iwasz/zephyr-grbl/doc/TMC2130-Pinout-with-Legend-1.jpg

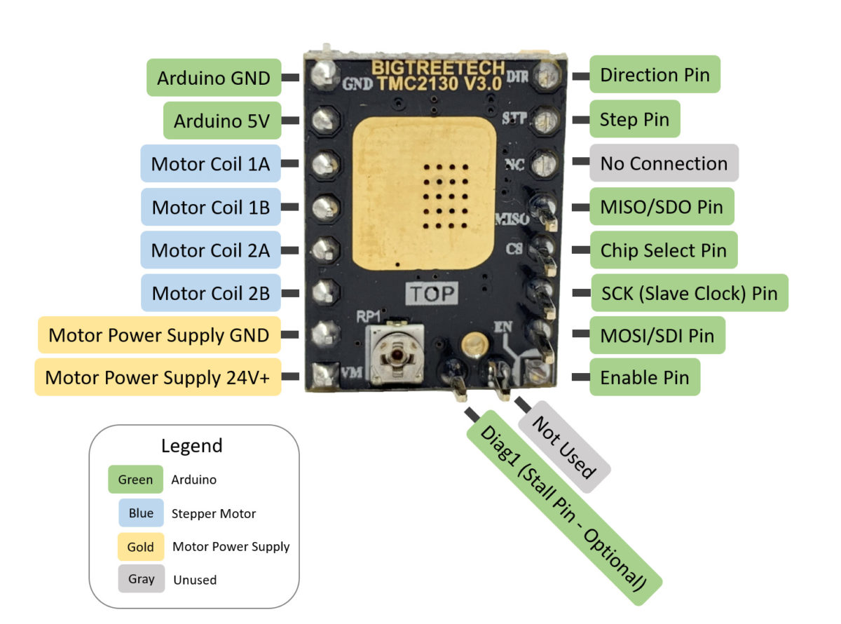
doc/TMC2130-Pinout-with-Legend-1.jpg
