iwasz/zephyr-grbl/pcb/plotter/plotter.jpg

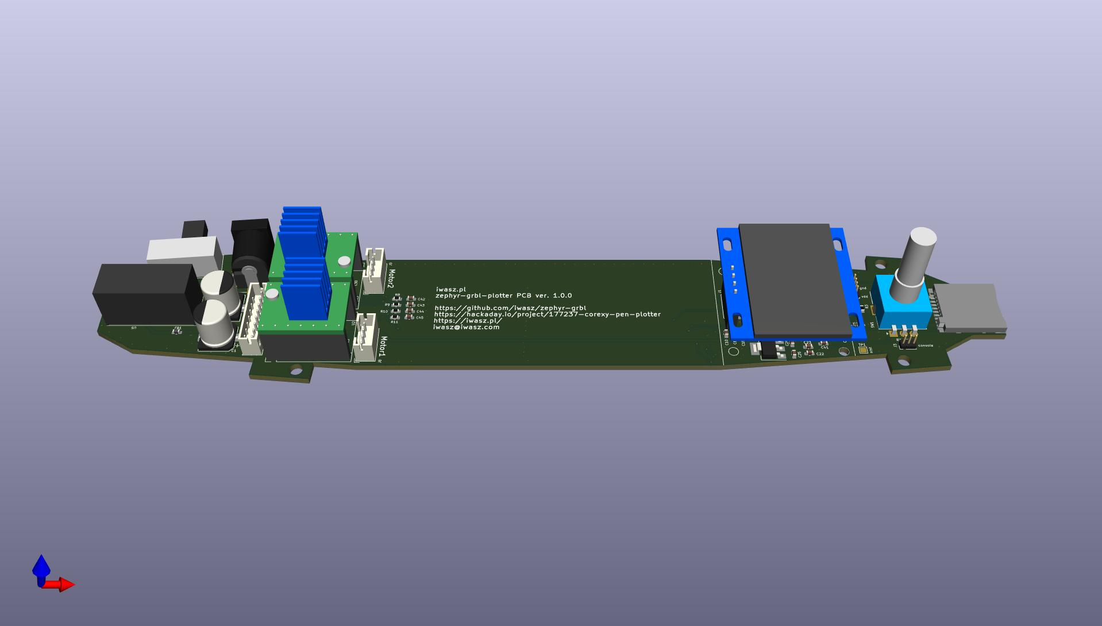
pcb/plotter/plotter.jpg
