iwasz/zephyr-grbl/freecad/plotter-dag-ModelEast attachment body.stl

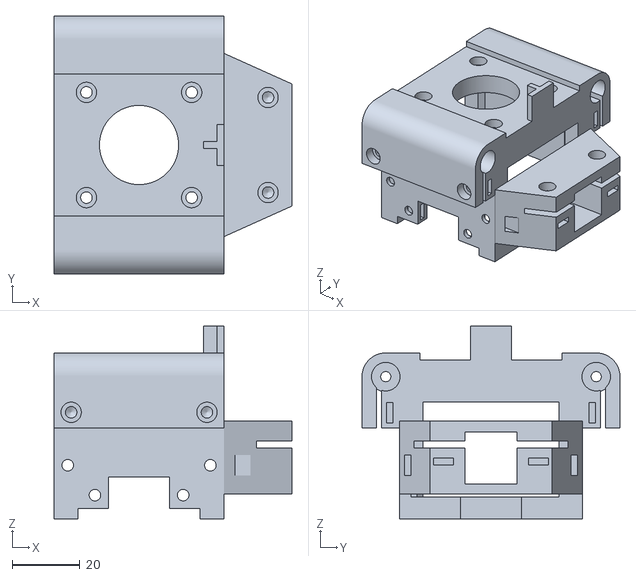
[picture p3: CAD file, 2021-11-13]
freecad/plotter-dag-ModelEast attachment body.stl
70.0 x 76.0 x 56.8
