iwasz/zephyr-grbl/freecad/misc.FCStd

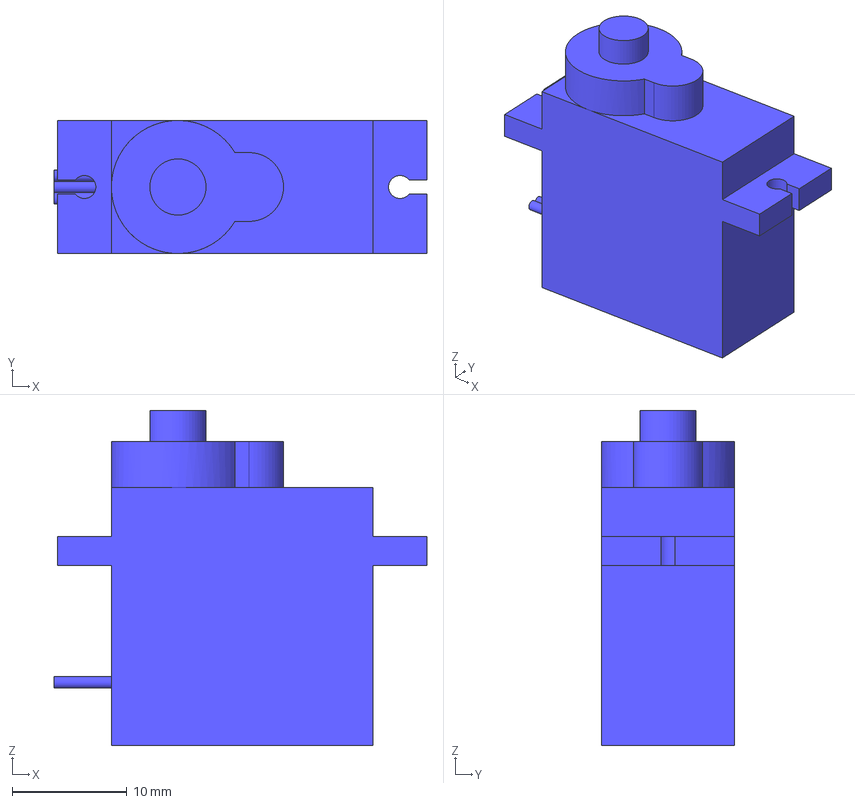
[picture p4: CAD file, 2021-11-13]
freecad/misc.FCStd
32.5 x 11.6 x 29.2 mm
