iwasz/zephyr-grbl/freecad/west-supports.3mf

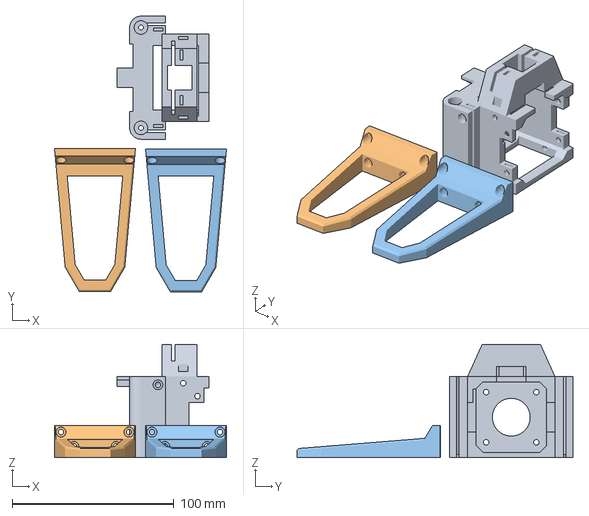
[picture p5: CAD file, 2021-11-13]
freecad/west-supports.3mf
106.2 x 170.2 x 70.0 mm
plotter-dag-ModelEast attachment body.stl
plotter-dag-ModelStand.stl x 2
