iwasz/zephyr-grbl/freecad/east-supports.3mf

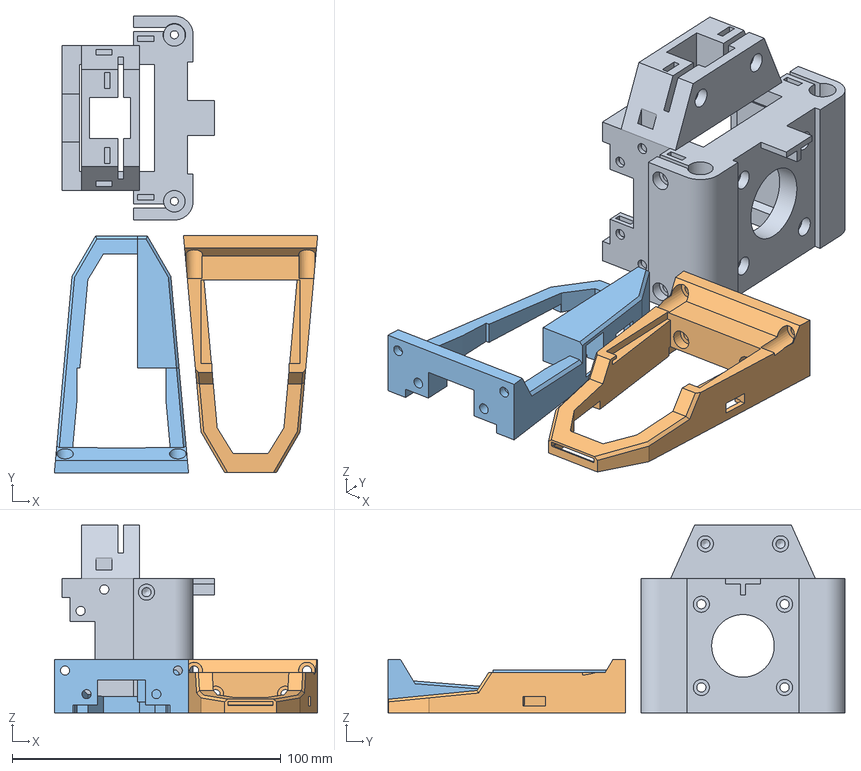
[picture p6: CAD file, 2021-11-13]
freecad/east-supports.3mf
98.1 x 170.2 x 70.0 mm
plotter-dag-ModelLink045(East attachment body).stl
plotter-dag-ModelStand001 (display).stl
plotter-dag-ModelStand002 (drivers).stl
