iwasz/zephyr-grbl/freecad/structure.FCStd

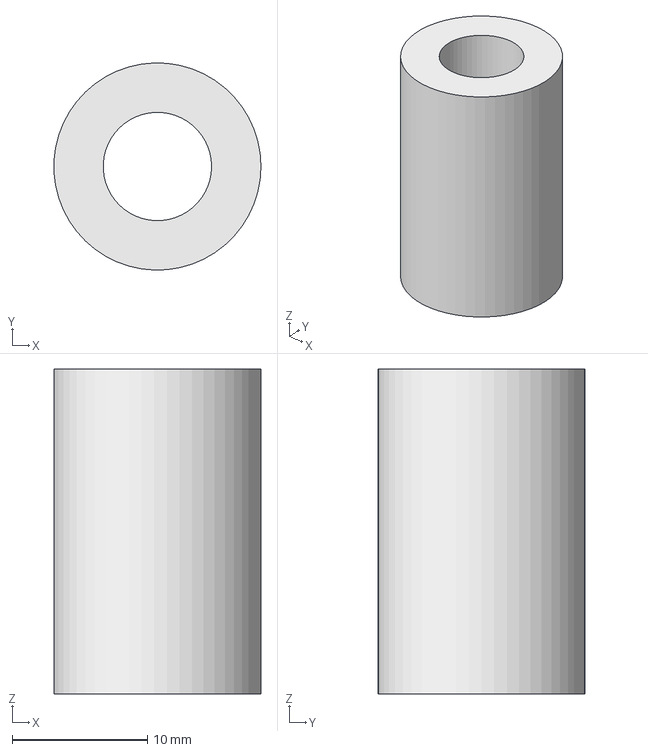
[picture p7: CAD file, 2021-11-13]
freecad/structure.FCStd
15.3 x 15.3 x 24.0 mm
