iwasz/zephyr-grbl/freecad/pcb.FCStd

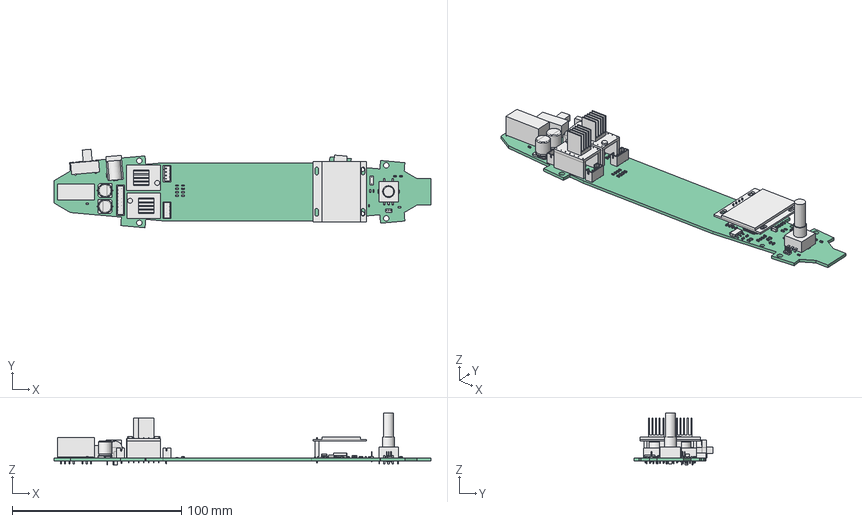
[picture p8: CAD file, 2021-11-13]
freecad/pcb.FCStd
222.6 x 46.4 x 30.5 mm
Pcb_8af9
C32_C_0603_1608Metric_dea1ef8ef69a x 38
C29_CP_Elec_8x10_c7fa17566931 x 4
R3_R_0603_1608Metric_c1fe3c621b06 x 13
J3_PinHeader_1x03_P127mm_Vertical_99a3a563f8fd
FB1_L_0603_1608Metric_5fb4f000be9f
SW2_Part_cp_a7f6e6a6a0c3
SW1_Part_cp001_6f12c7833242
U3_Part_cp_1e66df32675e x 2
U6_SOT_223_f1b97c54386c
U5_Part_cp_951aa2137d22
J2_PinHeader_1x04_P127mm_Vertical_8b0e2712847d
J5_Part_cp_6f4ee88f3ece
J1_Part_cp_9450c610c26b
J9_JST_B4B_PH_K_399ff7b9d37a x 2
C21_C_1206_3216Metric_187a28c8282d x 2
J6_Part_cp001_eeae0143ed6b
U1_LQFP_64_10x10mm_P05mm_76695abe2553
J10_JST_B8B_PH_K_8ebf37ab7c3a
C16_C_1210_3225Metric_90d36acb180e
