iwasz/zephyr-grbl/freecad/17HS4401.FCStd

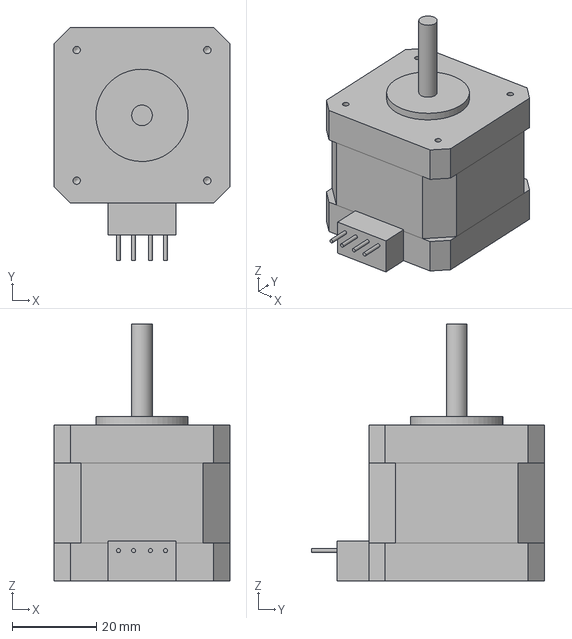
[picture p9: CAD file, 2021-11-13]
freecad/17HS4401.FCStd
41.7 x 55.3 x 61.0 mm
