iwasz/zephyr-grbl/freecad/plotter-dag-ModelStand002 (drivers).stl

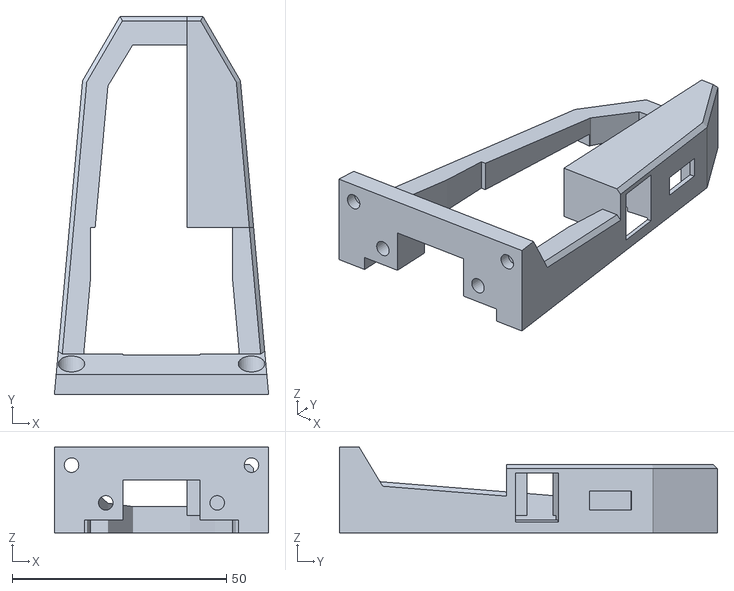
[picture p10: CAD file, 2021-11-13]
freecad/plotter-dag-ModelStand002 (drivers).stl
50.0 x 88.2 x 20.0
