iwasz/zephyr-grbl/freecad/plotter-dag-ModelSlice1.stl

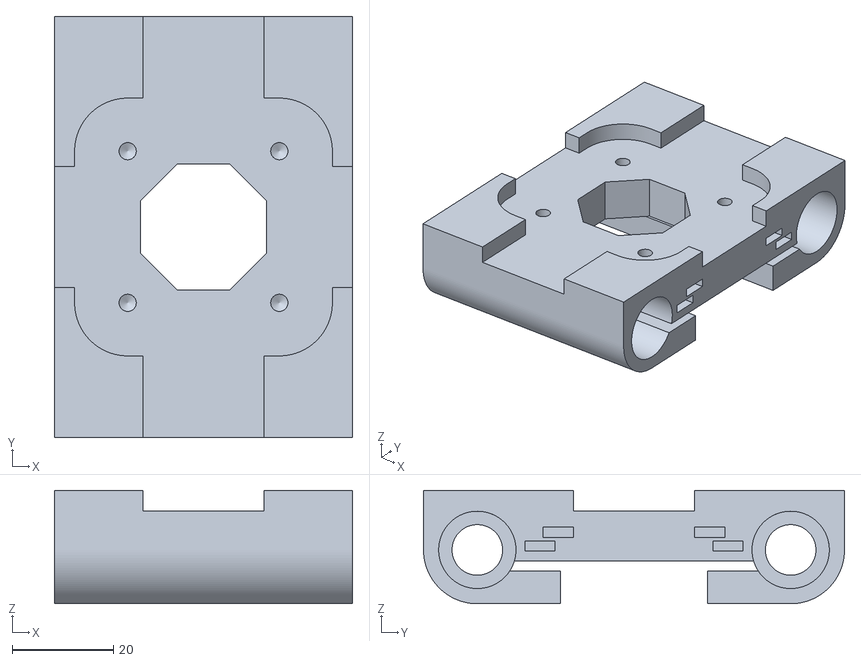
[picture p11: CAD file, 2021-11-13]
freecad/plotter-dag-ModelSlice1.stl
59.0 x 83.3 x 22.5
