iwasz/zephyr-grbl/freecad/gt2.FCStd

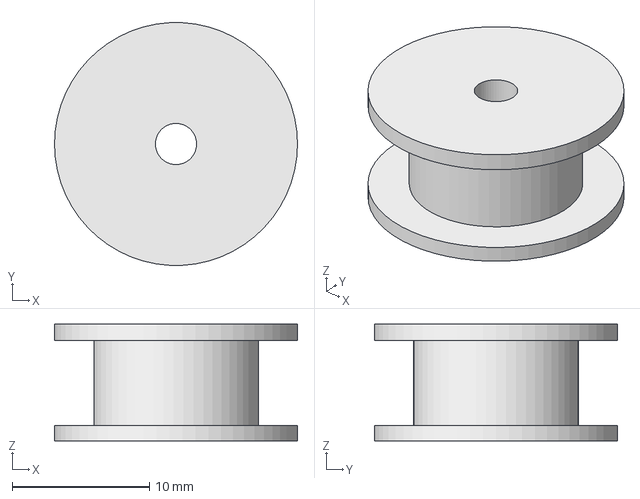
[picture p12: CAD file, 2021-11-13]
freecad/gt2.FCStd
17.7 x 17.7 x 8.50 mm
