iwasz/zephyr-grbl/freecad/carrier.3mf

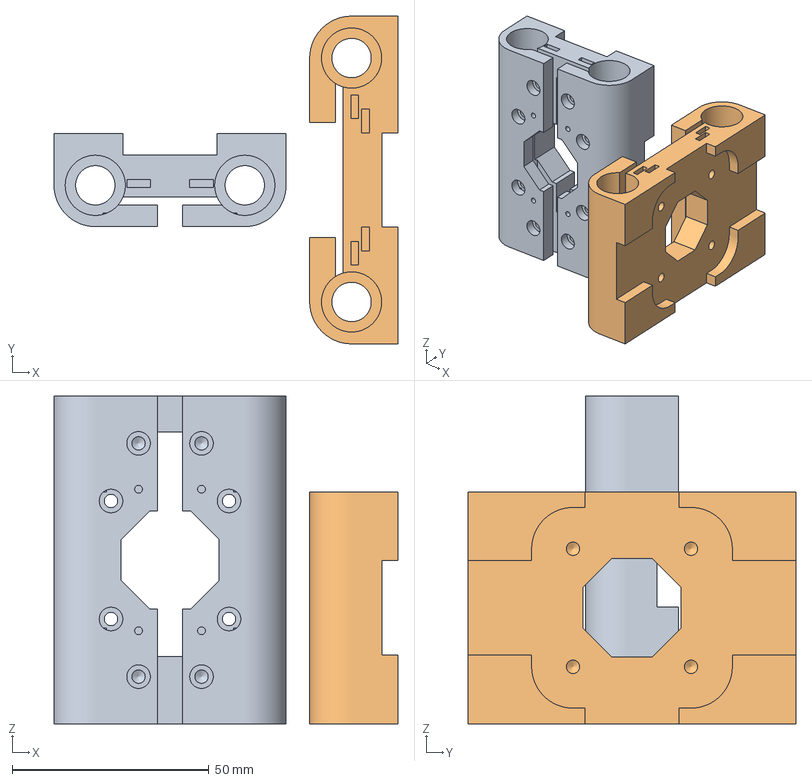
[picture p13: CAD file, 2021-11-13]
freecad/carrier.3mf
87.5 x 83.3 x 83.3 mm
plotter-dag-ModelSlice0.stl
plotter-dag-ModelSlice1.stl
