iwasz/zephyr-grbl/freecad/plotter-dag-ModelSlice0.stl

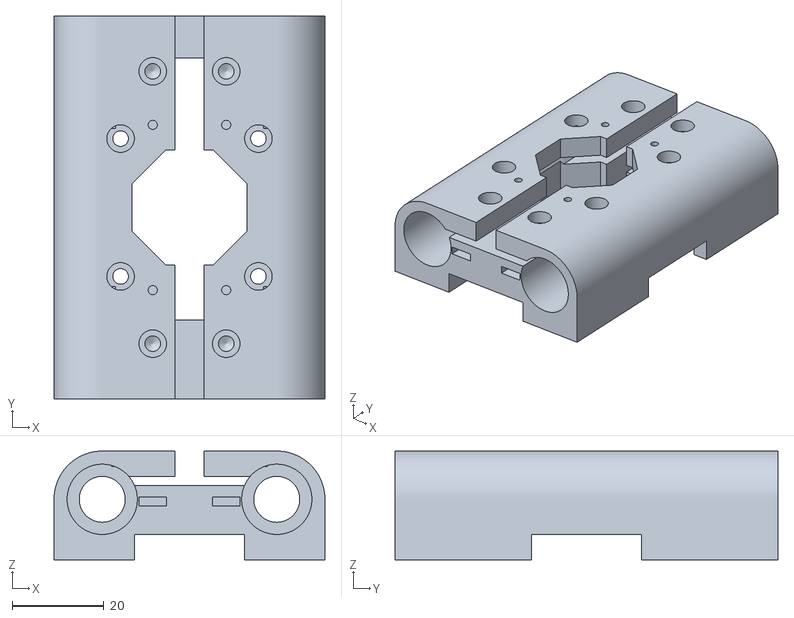
[picture p14: CAD file, 2021-11-13]
freecad/plotter-dag-ModelSlice0.stl
59.0 x 83.3 x 23.7
