iwasz/zephyr-grbl/freecad/plotter-dag-ModelStand001 (display).stl

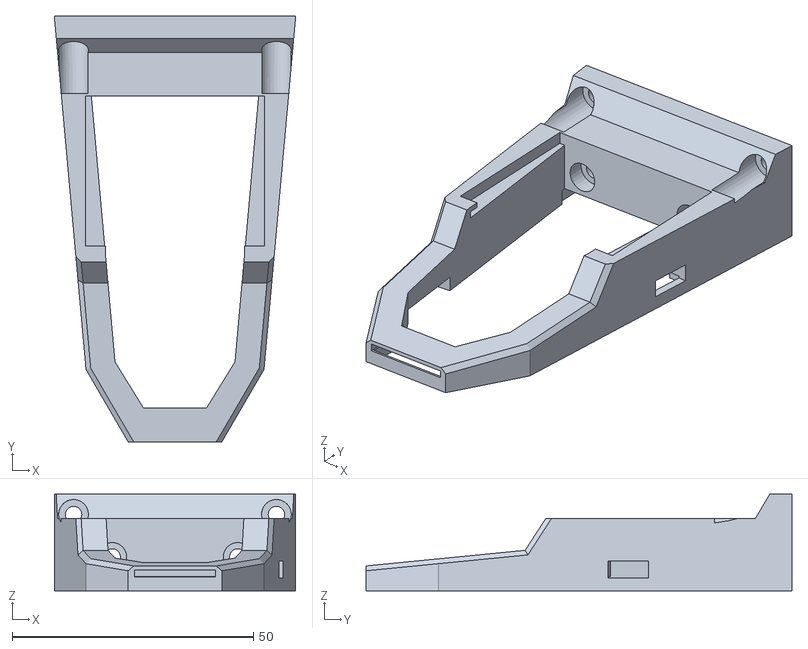
[picture p15: CAD file, 2021-11-13]
freecad/plotter-dag-ModelStand001 (display).stl
50.0 x 88.2 x 20.0
