iwasz/zephyr-grbl/freecad/plotter-dag-ModelStand.stl

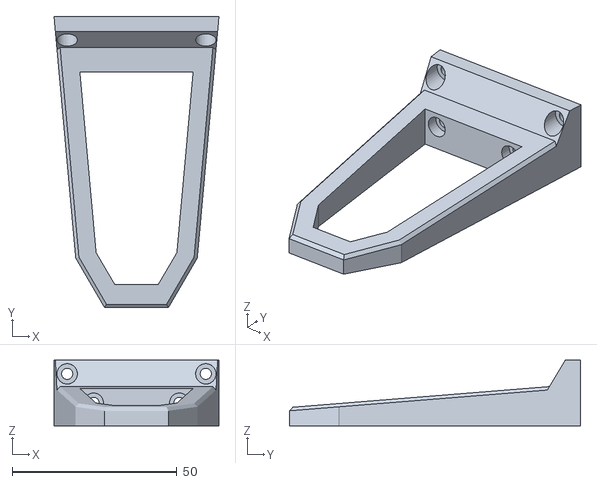
[picture p16: CAD file, 2021-11-13]
freecad/plotter-dag-ModelStand.stl
50.0 x 88.2 x 20.0
