iwasz/zephyr-grbl/freecad/pen-holder-compact.FCStd

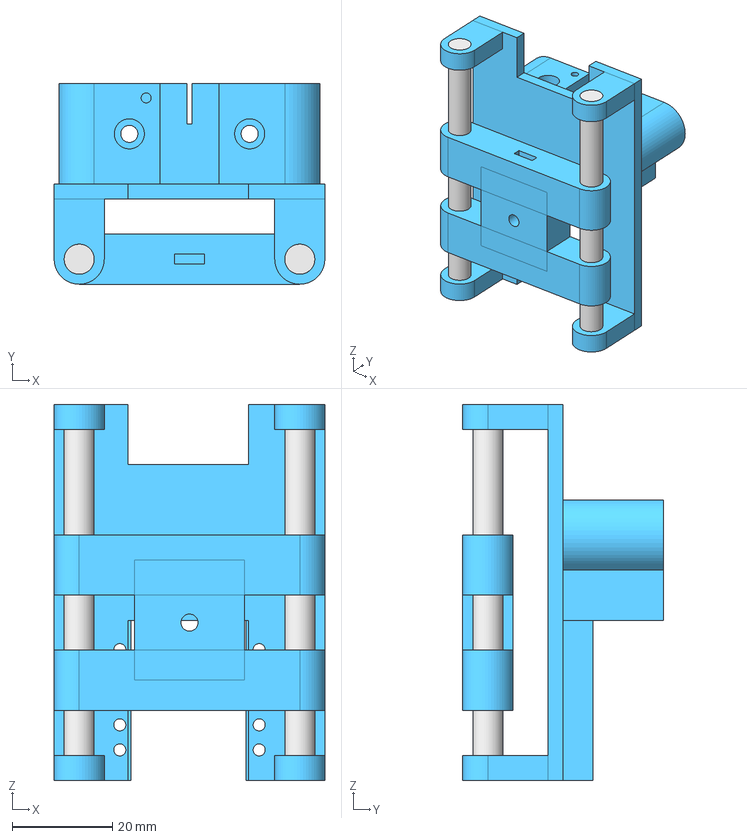
[picture p17: CAD file, 2021-11-13]
freecad/pen-holder-compact.FCStd
54.0 x 40.0 x 75.0 mm
South attachment body
rod x 2
SliderNoBeraring
