iwasz/zephyr-grbl/freecad/nema17.FCStd

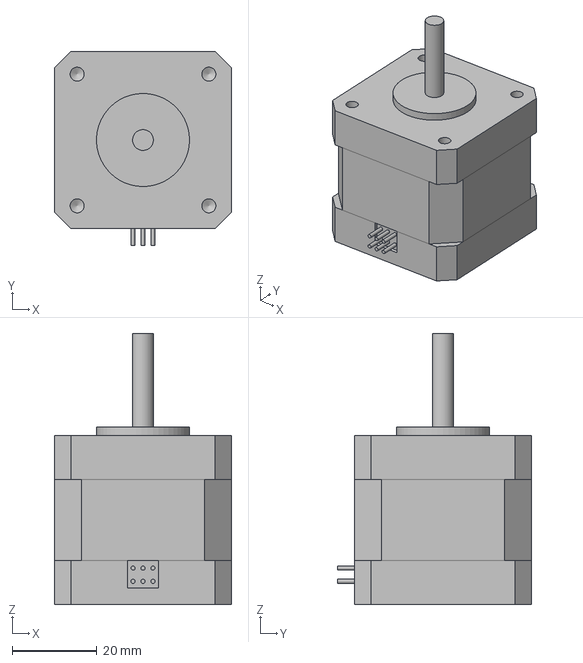
[picture p18: CAD file, 2021-09-21]
freecad/nema17.FCStd
41.7 x 45.7 x 63.8 mm
