iwasz/zephyr-grbl/freecad/pen-holder.FCStd

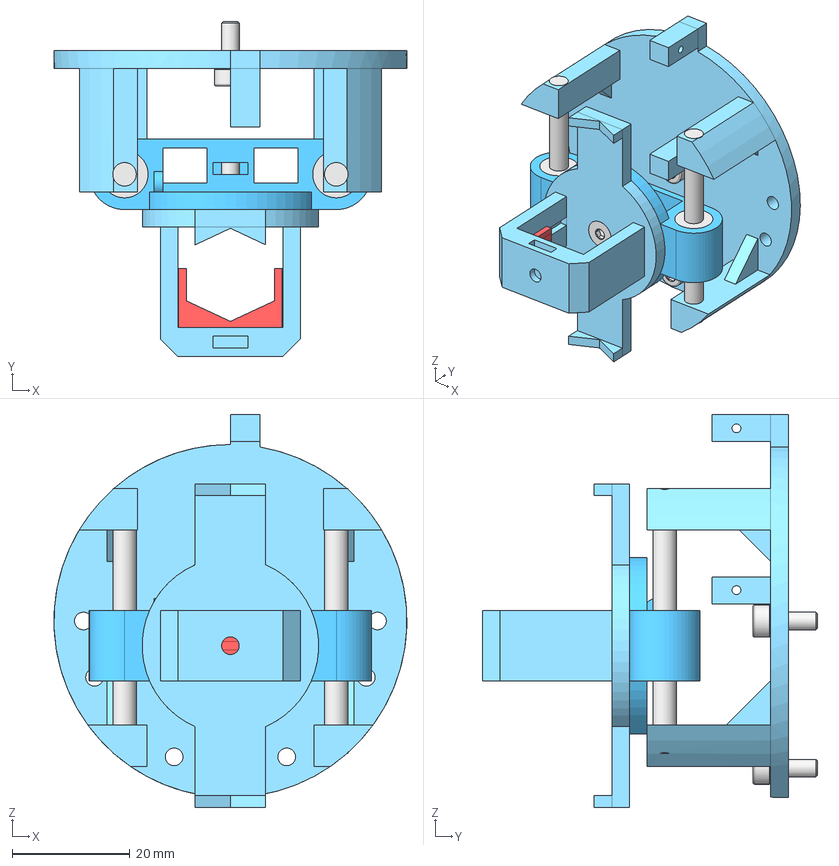
[picture p19: CAD file, 2021-09-21]
freecad/pen-holder.FCStd
60.0 x 57.0 x 66.8 mm
holder-body
rod x 2
LM4UU x 2
Slider body
SliderB body
M3x12-Screw
M3x8-Screw x 2
