iwasz/zephyr-grbl/test/README.md

Simple GRBL interfacing program. To be run on a PC.
