iwasz/zephyr-grbl/pcb/plotter/plotter.kicad_pcb

## KiCad design pcb/plotter/plotter.kicad_pcb (2023-07-04)

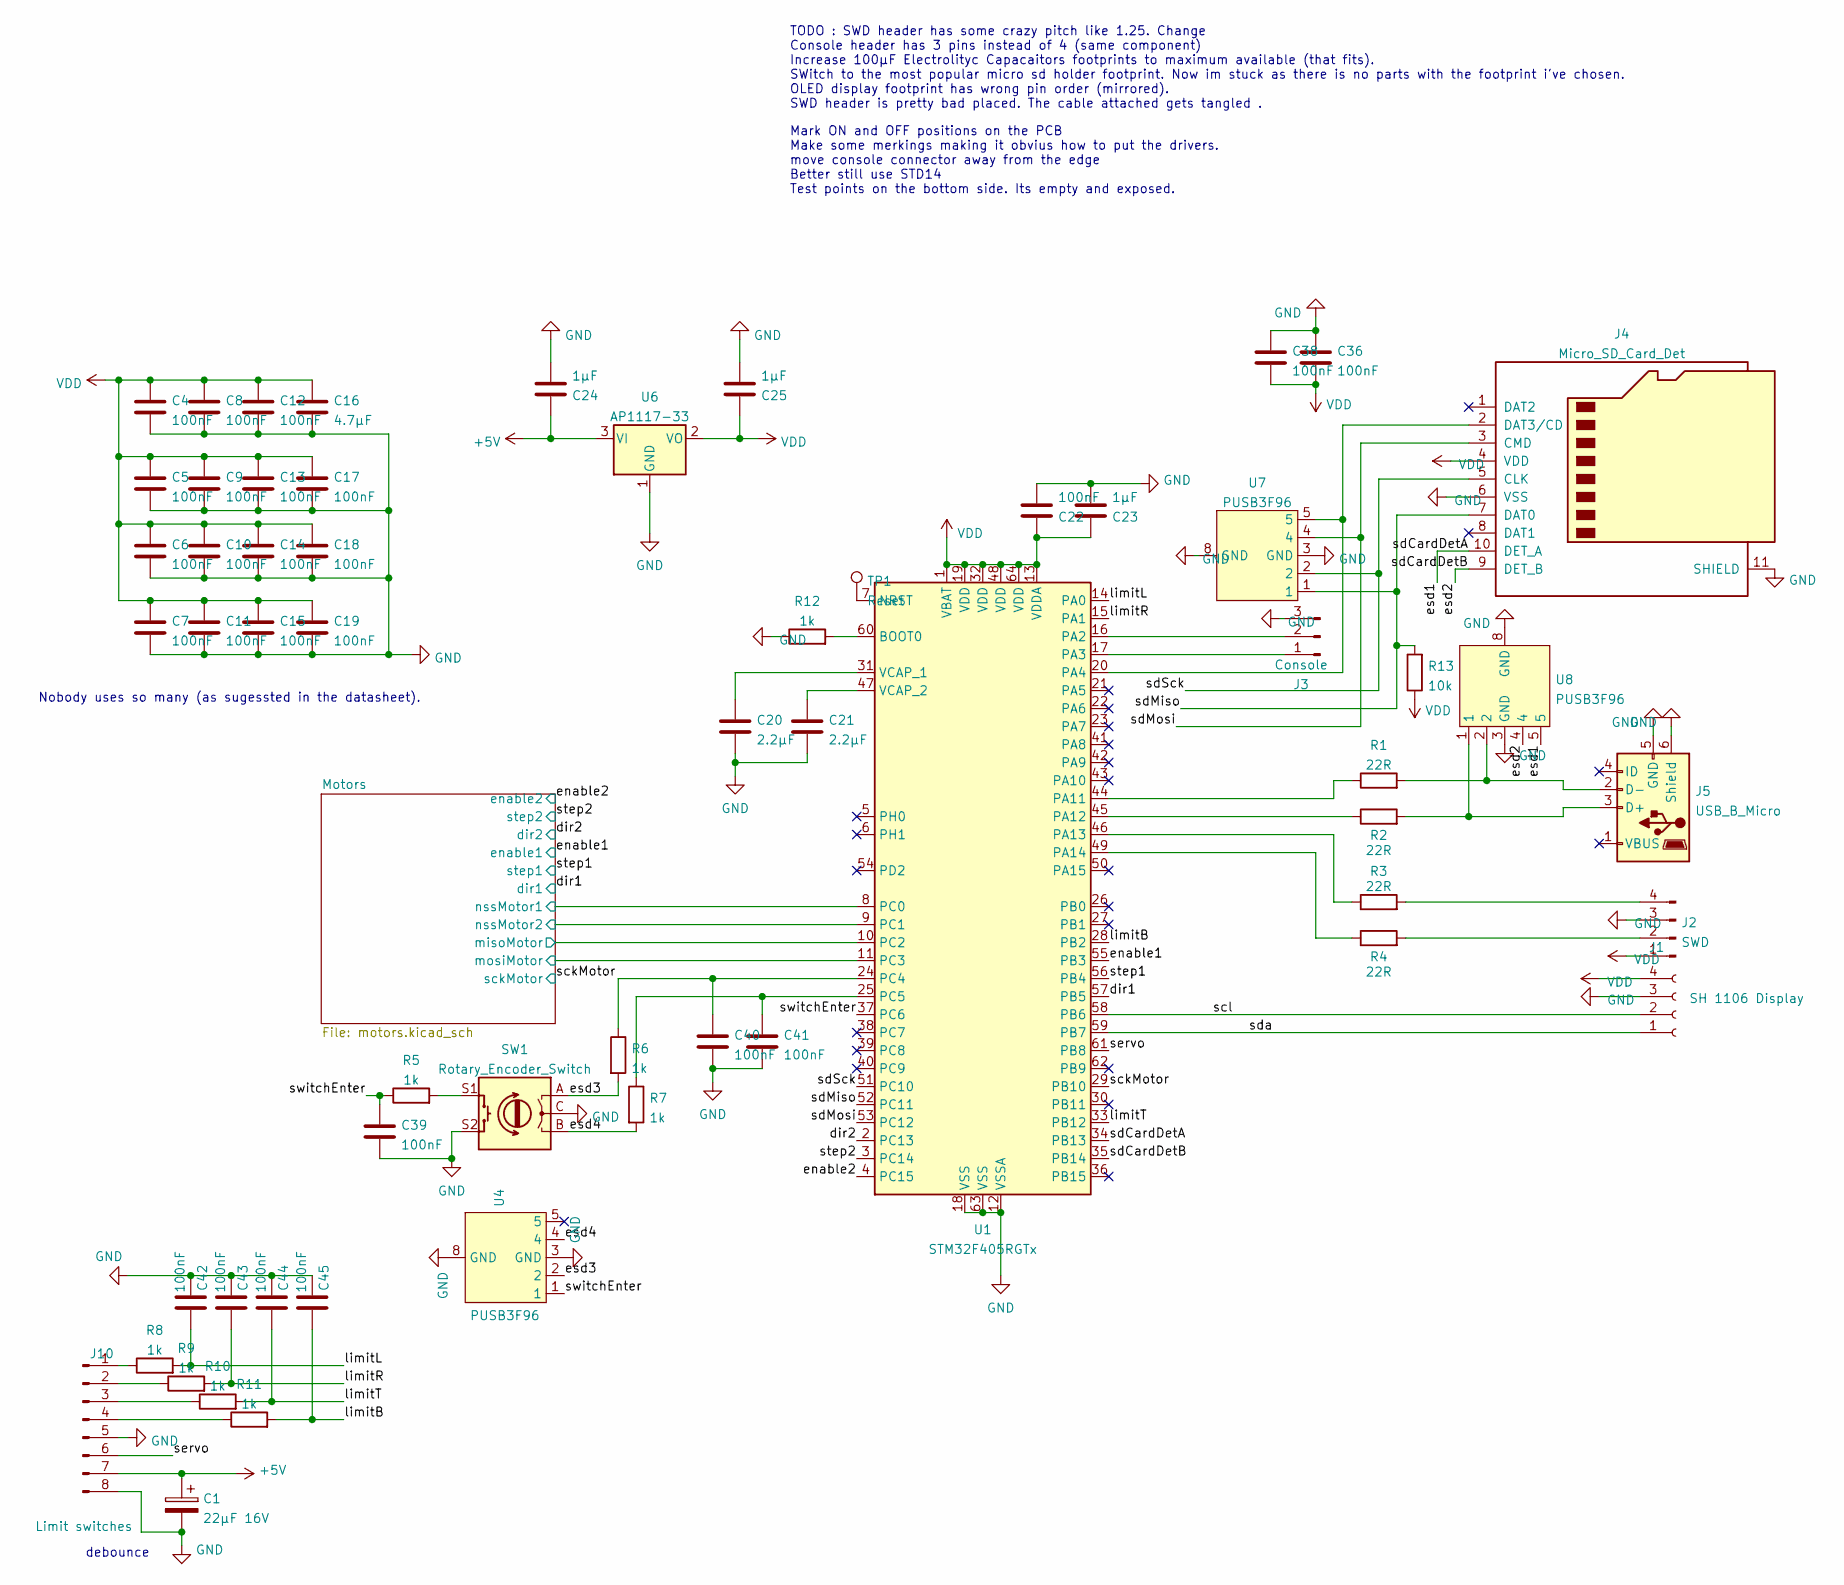
[picture p20: schematic plotter.kicad_sch]

Parts:
C1: 22µF 16V; CP_Elec_8x10
C4, C5, C6, C7, C8, C9, C10, C11, C12, C13, C14, C15, C17, C18, C19, C22, C36, C38, C39, C40, C41, C42, C43, C44, C45: 100nF; C_0603_1608Metric
C16: 4.7µF; C_1210_3225Metric
C20, C21: 2.2µF; C_1206_3216Metric
C23, C24, C25: 1µF; C_0603_1608Metric
J1: SH 1106 Display; SH1106
J2: SWD; PinHeader_1x04_P1.27mm_Vertical
J3: Console; PinHeader_1x03_P1.27mm_Vertical
J4: Micro_SD_Card_Det; microSD_HC_Hirose_DM3AT-SF-PEJM5
J5: USB_B_Micro; USB_Micro-B_Amphenol_10104110_Horizontal
J10: Limit switches; JST_PH_B8B-PH-K_1x08_P2.00mm_Vertical
R1, R2, R3, R4: 22R; R_0603_1608Metric
R5, R6, R7, R8, R9, R10, R11, R12: 1k; R_0603_1608Metric
R13: 10k; R_0603_1608Metric
SW1: Rotary_Encoder_Switch; RotaryEncoder_Alps_EC11E_Vertical_H20mm
TP1: Reset; TestPoint_Pad_1.5x1.5mm
U1: STM32F405RGTx; LQFP-64_10x10mm_P0.5mm
U4, U7, U8: PUSB3F96; Diodes_UDFN-10_1.0x2.5mm_P0.5mm
U6: AP1117-33; SOT-223-3_TabPin2

Connections:
+5V: C1.1, C24.1, J10.7, U6.3 (VI); also elsewhere on the board
/Motors/misoMotor: U1.10 (PC2); also elsewhere on the board
/Motors/mosiMotor: U1.11 (PC3); also elsewhere on the board
/Motors/nssMotor1: U1.8 (PC0); also elsewhere on the board
/Motors/nssMotor2: U1.9 (PC1); also elsewhere on the board
/dir1: U1.57 (PB5); also elsewhere on the board
/dir2: U1.2 (PC13); also elsewhere on the board
/enable1: U1.55 (PB3); also elsewhere on the board
/enable2: U1.4 (PC15); also elsewhere on the board
/esd1: J4.10 (DET_A), U1.34 (PB13), U8.5
/esd2: J4.9 (DET_B), U1.35 (PB14), U8.4
/esd3: R6.2, SW1.A, U4.2
/esd4: R7.2, SW1.B, U4.4
/limitB: C45.2, R11.2, U1.28 (PB2)
/limitL: C42.2, R8.2, U1.14 (PA0)
/limitR: C43.2, R9.2, U1.15 (PA1)
/limitT: C44.2, R10.2, U1.33 (PB12)
/sckMotor: U1.29 (PB10); also elsewhere on the board
/scl: J1.2, U1.58 (PB6)
/sdMiso: J4.7 (DAT0), R13.2, U1.52 (PC11), U7.1
/sdMosi: J4.3 (CMD), U1.53 (PC12), U7.4
/sdSck: J4.5 (CLK), U1.51 (PC10), U7.2
/sda: J1.1, U1.59 (PB7)
/servo: J10.6, U1.61 (PB8)
/step1: U1.56 (PB4); also elsewhere on the board
/step2: U1.3 (PC14); also elsewhere on the board
/switchEnter: C39.1, R5.1, U1.37 (PC6), U4.1
GND: C1.2, C4.2, C5.2, C6.2, C7.2, C8.2, C9.2, C10.2, C11.2, C12.2, C13.2, C14.2, C15.2, C16.2, C17.2, C18.2, C19.2, C20.2, C21.2, C22.2, C23.2, C24.2, C25.2, C36.1, C38.1, C39.2, C40.2, C41.2, C42.1, C43.1, C44.1, C45.1, J1.3, J2.3, J3.3, J4.6 (VSS), J4.11 (SHIELD), J5.5 (GND), J5.6 (Shield), J10.5, J10.8, R12.1, SW1.C, SW1.S2, U1.12 (VSSA), U1.18 (VSS), U1.63 (VSS), U4.3 (GND), U4.8 (GND), U6.1 (GND), U7.3 (GND), U7.8 (GND), U8.3 (GND), U8.8 (GND); also elsewhere on the board
unnamed: C20.1, U1.31 (VCAP_1)
unnamed: C21.1, U1.47 (VCAP_2)
unnamed: C40.1, R6.1, U1.24 (PC4)
unnamed: C41.1, R7.1, U1.25 (PC5)
unnamed: J2.2, R4.2
unnamed: J2.4, R3.2
unnamed: J3.1, U1.17 (PA3)
unnamed: J3.2, U1.16 (PA2)
unnamed: J4.2 (DAT3/CD), U1.20 (PA4), U7.5
unnamed: J5.2 (D-), R1.2, U8.2
unnamed: J5.3 (D+), R2.2, U8.1
unnamed: J10.1, R8.1
unnamed: J10.2, R9.1
unnamed: J10.3, R10.1
unnamed: J10.4, R11.1
unnamed: R1.1, U1.44 (PA11)
unnamed: R2.1, U1.45 (PA12)
unnamed: R3.1, U1.46 (PA13)
unnamed: R4.1, U1.49 (PA14)
unnamed: R5.2, SW1.S1
unnamed: R12.2, U1.60 (BOOT0)
unnamed: TP1.1, U1.7 (NRST)
VDD: C4.1, C5.1, C6.1, C7.1, C8.1, C9.1, C10.1, C11.1, C12.1, C13.1, C14.1, C15.1, C16.1, C17.1, C18.1, C19.1, C22.1, C23.1, C25.1, C36.2, C38.2, J1.4, J2.1, J4.4 (VDD), R13.1, U1.1 (VBAT), U1.13 (VDDA), U1.19 (VDD), U1.32 (VDD), U1.48 (VDD), U1.64 (VDD), U6.2 (VO)

Notes on the sheet:
Nobody uses so many (as sugessted in the datasheet).
TODO : SWD header has some crazy pitch like 1.25. Change Console header has 3 pins instead of 4 (same component) Increase 100µF Electrolityc Capacaitors footprints to maximum available (that fits). SWitch to the most popular micro sd holder footprint. Now im stuck as there is no parts with the foot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
Mark ON and OFF positions on the PCB Make some merkings making it obvius how to put the drivers. move console connector away from the edge Better still use STD14 Test points on the bottom side. Its empty and exposed.
debounce

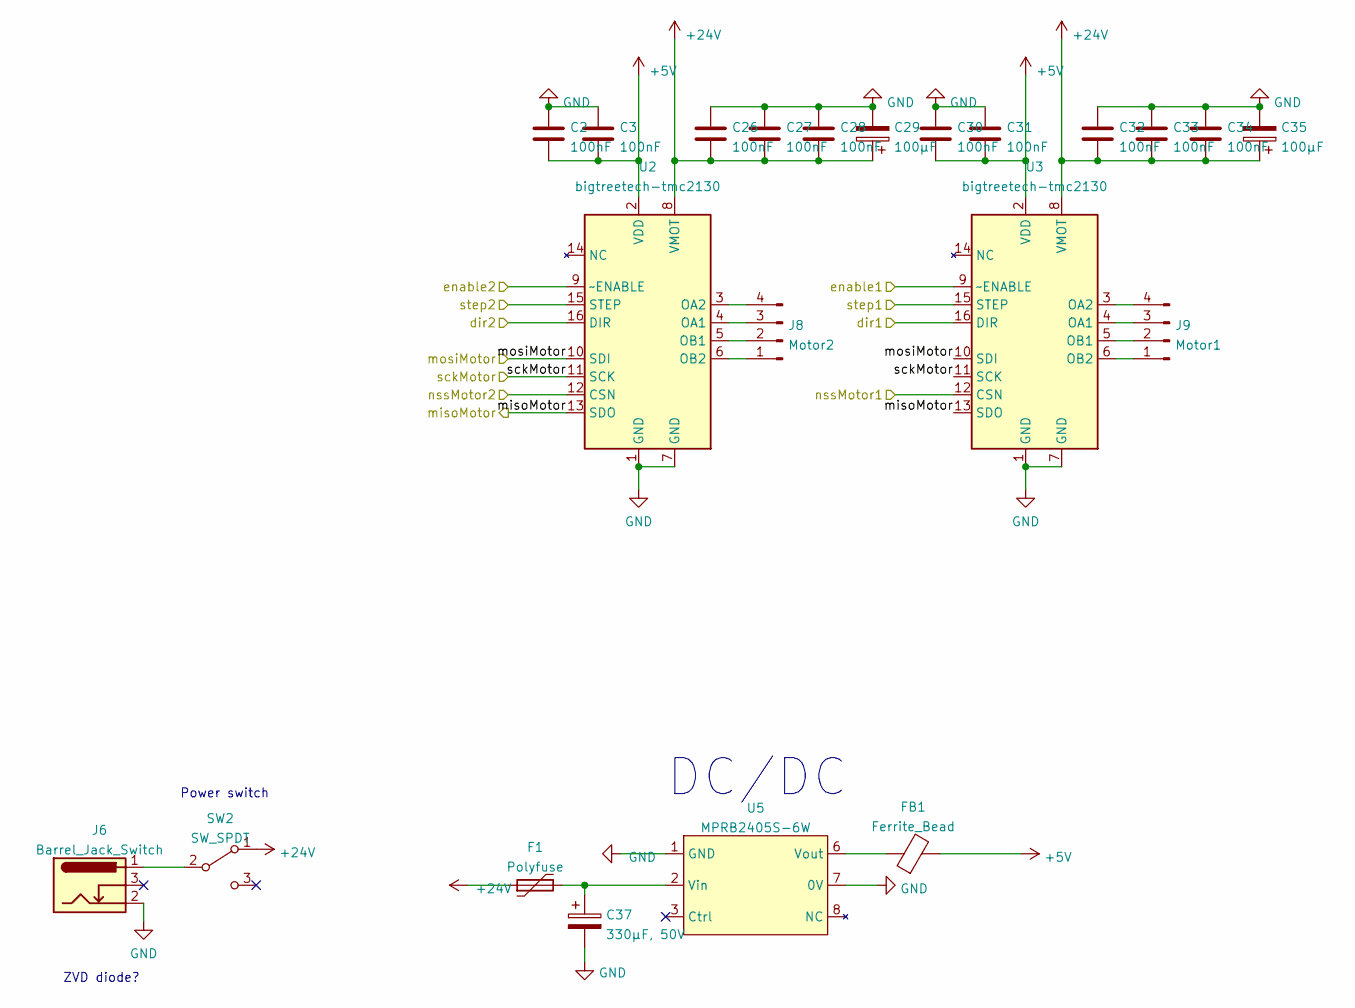
[picture p21: schematic motors.kicad_sch]

Parts:
C2, C3, C26, C27, C28, C30, C31, C32, C33, C34: 100nF; C_0603_1608Metric
C29, C35: 100µF; CP_Elec_8x10
C37: 330µF, 50V; CP_Elec_8x10
F1: Polyfuse; Fuse_1812_4532Metric
FB1: Ferrite_Bead; L_0603_1608Metric
J6: Barrel_Jack_Switch; BarrelJack_Horizontal
J8: Motor2; JST_PH_B4B-PH-K_1x04_P2.00mm_Vertical
J9: Motor1; JST_PH_B4B-PH-K_1x04_P2.00mm_Vertical
SW2: SW_SPDT; MFP 201 NR_copy
U2, U3: bigtreetech-tmc2130; Pololu_Breakout-16_15.2x20.3mm
U5: MPRB2405S-6W

Connections:
+5V: C2.2, C3.2, C30.2, C31.2, FB1.2, U2.2 (VDD), U3.2 (VDD); also elsewhere on the board
+24V: C26.2, C27.2, C28.2, C29.1, C32.2, C33.2, C34.2, C35.1, F1.1, SW2.1 (A), U2.8 (VMOT), U3.8 (VMOT)
/Motors/misoMotor: U2.13 (SDO), U3.13 (SDO); also elsewhere on the board
/Motors/mosiMotor: U2.10 (SDI), U3.10 (SDI); also elsewhere on the board
/Motors/nssMotor1: U3.12 (CSN); also elsewhere on the board
/Motors/nssMotor2: U2.12 (CSN); also elsewhere on the board
/dir1: U3.16 (DIR); also elsewhere on the board
/dir2: U2.16 (DIR); also elsewhere on the board
/enable1: U3.9 (~ENABLE); also elsewhere on the board
/enable2: U2.9 (~ENABLE); also elsewhere on the board
/sckMotor: U2.11 (SCK), U3.11 (SCK); also elsewhere on the board
/step1: U3.15 (STEP); also elsewhere on the board
/step2: U2.15 (STEP); also elsewhere on the board
GND: C2.1, C3.1, C26.1, C27.1, C28.1, C29.2, C30.1, C31.1, C32.1, C33.1, C34.1, C35.2, C37.2, J6.2, U2.1 (GND), U2.7 (GND), U3.1 (GND), U3.7 (GND), U5.1 (GND), U5.7 (0V); also elsewhere on the board
unnamed: C37.1, F1.2, U5.2 (Vin)
unnamed: FB1.1, U5.6 (Vout)
unnamed: J6.1, SW2.2 (B)
unnamed: J8.1, U2.6 (OB2)
unnamed: J8.2, U2.5 (OB1)
unnamed: J8.3, U2.4 (OA1)
unnamed: J8.4, U2.3 (OA2)
unnamed: J9.1, U3.6 (OB2)
unnamed: J9.2, U3.5 (OB1)
unnamed: J9.3, U3.4 (OA1)
unnamed: J9.4, U3.3 (OA2)

Notes on the sheet:
DC/DC
Power switch
ZVD diode?

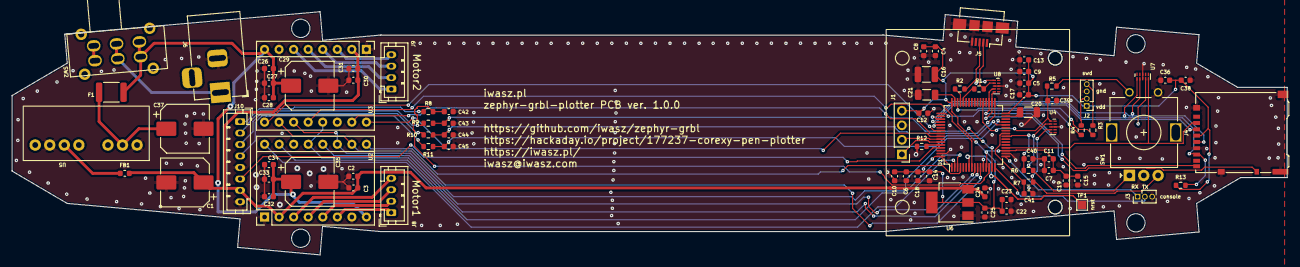
[picture p22: board plotter.kicad_pcb from above]

Board: 2 copper layers, 222.6 x 42.4 mm, 80 parts (0 on the bottom side), 63 nets.
