iwasz/zephyr-grbl/misc/misc.ioc

Mcu.UserName=STM32F405RGTx
PA0-WKUP.Signal=GPIO_Input
PA1.Signal=GPIO_Input
PA11.Signal=USB_OTG_FS_DM
PA12.Signal=USB_OTG_FS_DP
PA13.Signal=SYS_JTMS-SWDIO
PA14.Signal=SYS_JTCK-SWCLK
PA2.Signal=USART2_TX
PA3.Signal=USART2_RX
PA4.Signal=SPI1_NSS
PA5.Signal=SPI1_SCK
PA6.Signal=SPI1_MISO
PA7.Signal=SPI1_MOSI
PB10.Signal=SPI2_SCK
PB11.Signal=GPIO_Output
PB12.Signal=GPIO_Input
PB13.Signal=GPIO_Input
PB14.Signal=GPIO_Input
PB2.Signal=GPIO_Input
PB3.Signal=GPIO_Output
PB4.Signal=GPIO_Output
PB5.Signal=GPIO_Output
PB6.Signal=I2C1_SCL
PB7.Signal=I2C1_SDA
PB8.Signal=S_TIM4_CH3
PC0.Signal=GPIO_Input
PC1.Signal=GPIO_Output
PC10.Signal=SPI3_SCK
PC11.Signal=SPI3_MISO
PC12.Signal=SPI3_MOSI
PC13-ANTI_TAMP.Signal=GPIO_Output
PC14-OSC32_IN.Signal=GPIO_Output
PC15-OSC32_OUT.Signal=GPIO_Output
PC2.Signal=SPI2_MISO
PC3.Signal=SPI2_MOSI
PC4.Signal=GPIO_Input
PC5.Signal=GPIO_Input
PC6.Signal=GPIO_Input
