iwasz/zephyr-grbl/src/display.cc

/****************************************************************************
 *                                                                          *
 *  Author : lukasz.iwaszkiewicz@gmail.com                                  *
 *  ~~~~~~~~                                                                *
 *  License : see COPYING file for details.                                 *
 *  ~~~~~~~~~                                                               *
 ****************************************************************************/

#include "display.h"
#include "Machine.h"
#include "cfb_font_oldschool.h"
#include "grblState.h"
#include "sdCard.h"
#include <array>
#include <optional>
#include <zephyr/device.h>
#include <zephyr/devicetree.h>
#include <zephyr/display/cfb.h>
#include <zephyr/drivers/gpio.h>
#include <zephyr/init.h>
#include <zephyr/kernel.h>
#include <zephyr/logging/log.h>

LOG_MODULE_REGISTER (display);

int sysInit ()
{
        /*
         * This is a hack to delay OLED screen initialization. Assumption is that CONFIG_DISPLAY_INIT_PRIORITY is
         * higher than 0. This works by adding a function with the same init level as the ssd1306 driver (POST_KERNEL)
         * but with lower priority number which makes it run prior the oled driver initialization. Suggestions as to
         * how to do it better are welcomed.
         */
        k_sleep (K_MSEC (50));
        return 0;
}

SYS_INIT (sysInit, POST_KERNEL, 0);

namespace {
void displayThread (void *, void *, void *);
K_THREAD_DEFINE (disp, 2048, displayThread, NULL, NULL, NULL, 14, 0, 0);
} // namespace

namespace disp {

namespace {
        const gpio_dt_spec encoderA = GPIO_DT_SPEC_GET (DT_PATH (ui_buttons, encoder_a), gpios);
        const gpio_dt_spec encoderB = GPIO_DT_SPEC_GET (DT_PATH (ui_buttons, encoder_b), gpios);
        const gpio_dt_spec encoderEnter = GPIO_DT_SPEC_GET (DT_PATH (ui_buttons, enter), gpios);
        const struct device *display{};
} // namespace

void init ()
{
        k_sleep (K_MSEC (10));

        display = device_get_binding ("SSD1306");

        if (display == NULL) {
                LOG_ERR ("Device not found\n");
                return;
        }

        if (!device_is_ready (display)) {
                LOG_ERR ("Device not ready, aborting test");
                return;
        }

        if (display_set_pixel_format (display, PIXEL_FORMAT_MONO10) != 0) {
                LOG_ERR ("Failed to set required pixel format\n");
                return;
        }

        if (cfb_framebuffer_init (display)) {
                LOG_ERR ("Framebuffer initialization failed!\n");
                return;
        }

        cfb_framebuffer_clear (display, true);
        display_blanking_off (display);

        cfb_framebuffer_set_font (disp::display, 0);
        cfb_framebuffer_invert (display);

        /*--------------------------------------------------------------------------*/

        if (!gpio_is_ready_dt (&encoderA)) {
                LOG_ERR ("encoderA !ready");
        }

        if (!gpio_is_ready_dt (&encoderB)) {
                LOG_ERR ("encoderB !ready");
        }

        if (!gpio_is_ready_dt (&encoderEnter)) {
                LOG_ERR ("encoderEnter !ready");
        }

        int ret = gpio_pin_configure_dt (&encoderA, GPIO_INPUT);
        ret |= gpio_pin_configure_dt (&encoderB, GPIO_INPUT);
        ret |= gpio_pin_configure_dt (&encoderEnter, GPIO_INPUT);

        if (ret != 0) {
                LOG_ERR ("Encoder init failed");
        }
}

} // namespace disp

/**
 * UI related.
 */
namespace {

enum class MenuType { main, jog, sdCard };

auto menu = [] (MenuType menuType, int selected) {
        cfb_framebuffer_clear (disp::display, false);
        uint16_t margin = 2;

        switch (menuType) {
        case MenuType::main:
                cfb_print (disp::display, "  Print from SD", margin, 0);
                cfb_print (disp::display, "  Jogging menu", margin, 8);
                break;

        case MenuType::jog:
                cfb_print (disp::display, "  Y+", margin, 0);
                cfb_print (disp::display, "  Y-", margin, 8);
                cfb_print (disp::display, "  X+", margin, 16);
                cfb_print (disp::display, "  X-", margin, 24);
                cfb_print (disp::display, "  Back", margin, 32);
                break;

        default:
                break;
        }

        cfb_print (disp::display, ">", 2, selected * 8);
        cfb_framebuffer_finalize (disp::display);
};

/**
 * Prints file entries from the SD.
 */
void sdMenu (int selected)
{
        cfb_framebuffer_clear (disp::display, false);
        uint16_t margin = 2;
        cfb_print (disp::display, "  Back", margin, 0);

        sd::lsdir ("");

        cfb_print (disp::display, ">", 2, selected * 8);
        cfb_framebuffer_finalize (disp::display);
}

/**
 *
 */
enum class Event { none, left, right, enter };

constexpr auto enter = [] (Event e) { return e == Event::enter; };
constexpr auto left = [] (Event e) { return e == Event::left; };
constexpr auto right = [] (Event e) { return e == Event::right; };

using namespace ls;
auto menuMachine = machine (
        /*--------------------------------------------------------------------------*/
        /* Main menu                                                                */
        /*--------------------------------------------------------------------------*/

        state ("MAIN_SD"_ST, entry ([] { menu (MenuType::main, 0); }), //
               transition ("MAIN_JOG"_ST, left),                       // Next menu item
               transition ("MAIN_JOG"_ST, right),                      // Prev menu item
               transition ("JOG_YP"_ST, enter)),                       // Enter

        state ("MAIN_JOG"_ST, entry ([] { menu (MenuType::main, 1); }), //
               transition ("MAIN_SD"_ST, left),                         // Next menu item
               transition ("MAIN_SD"_ST, right),                        // Prev menu item
               transition ("JOG_YP"_ST, enter)),                        // Enter

        /*--------------------------------------------------------------------------*/
        /* SD card menu                                                             */
        /*--------------------------------------------------------------------------*/

        state ("SD"_ST, entry ([] { sdMenu (0); }) //
               /* transition ("MAIN_SD"_ST, left),                   // Next menu item
               transition ("MAIN_SD"_ST, right),                  // Prev menu item
               transition ("JOG_YP"_ST, enter) */),                  // Enter

        /*--------------------------------------------------------------------------*/
        /* Jog menu                                                                 */
        /*--------------------------------------------------------------------------*/

        state ("JOG_YP"_ST, entry ([] { menu (MenuType::jog, 0); }), // Jog along Y axis in positive direction.
               transition ("JOG_YN"_ST, left),                       // Next menu item
               transition ("JOG_BACK"_ST, right),                    // Prev menu item
               transition ("JOG_YP"_ST, enter, [] (auto) { grbl::jog (grbl::JogDirection::yPositive); })),

        state ("JOG_YN"_ST, entry ([] { menu (MenuType::jog, 1); }), //
               transition ("JOG_XP"_ST, left),                       //
               transition ("JOG_YP"_ST, right),                      //
               transition ("JOG_YN"_ST, enter, [] (auto) { grbl::jog (grbl::JogDirection::yNegative); })),

        state ("JOG_XP"_ST, entry ([] { menu (MenuType::jog, 2); }), //
               transition ("JOG_XN"_ST, left),                       //
               transition ("JOG_YN"_ST, right),                      //
               transition ("JOG_XP"_ST, enter, [] (auto) { grbl::jog (grbl::JogDirection::xPositive); })),

        state ("JOG_XN"_ST, entry ([] { menu (MenuType::jog, 3); }),                                       //
               transition ("JOG_BACK"_ST, left),                                                           //
               transition ("JOG_XP"_ST, right),                                                            //
               transition ("JOG_XN"_ST, enter, [] (auto) { grbl::jog (grbl::JogDirection::yPositive); })), //

        state ("JOG_BACK"_ST, entry ([] { menu (MenuType::jog, 4); }), //
               transition ("JOG_YP"_ST, left),                         //
               transition ("JOG_XN"_ST, right),                        //
               transition ("MAIN_JOG"_ST, enter))                       //
);

void displayThread (void *, void *, void *)
{
        using namespace disp;

        init ();

        // Enter into initial state, and execute its entry state (that displays the menu).
        menuMachine.run (Event::none);
        bool prevE{};
        uint8_t state = 0x04;
        uint8_t output{};
        bool first = true;

        while (true) {
                constexpr std::array<std::array<uint8_t, 4>, 5> ENC = {{
                        {0x00, 0x01, 0x02, 0x01},
                        {0x10, 0x01, 0x01, 0x23},
                        {0x20, 0x01, 0x02, 0x13},
                        {0x01, 0x01, 0x02, 0x03},
                }};

                uint8_t event = gpio_pin_get_dt (&encoderB) << 1 | gpio_pin_get_dt (&encoderA);
                auto x = ENC[state][event];
                state = x & 0x03;

                if (!first) {
                        output = x & 0x30;
                }

                first = false;

                if (bool e = gpio_pin_get_dt (&encoderEnter); e != prevE) {
                        prevE = e;

                        if (e) {
                                menuMachine.run (Event::enter);
                        }
                }

                if (output == 0x20) {
                        menuMachine.run (Event::left);
                }
                else if (output == 0x10) {
                        menuMachine.run (Event::right);
                }

                k_sleep (K_MSEC (4));
        }
}
} // namespace
