iwasz/zephyr-grbl/(commit log)

2020-11-12 First motor movement
2020-11-16 Both motors work, plotter moves both ways.
2020-11-24 Nucleo 743 support, because I fried the discovery board (and one TMC driver at the same time).
2020-12-09 Works with hardware timer
2021-01-18 Stepper.c compiles
2021-01-20 UART IRQ mode
2021-01-20 Switched back to H7 when I discovered, that no DMA is necessary.
2021-08-19 Switch to F446re. Compiles, hangs on USART3 comms.
2021-09-02 Zephyr ring buffers used along with the CDC ACM USB class. In this commit the Zephyr console prints on the usual USB2, and GRBL communicates through the CDC ACM.
2021-09-03 Priority of the main thread lowered to 14, and k_yeld added in the GRBL.
2021-09-07 Z axis, and some examples. Still work in progress, but at this point it draws rather nicely.
2021-09-08 32 bit timer used for generating stepper pulses.
2021-09-10 Cleanup of GRBL modifications - I"m incorporating the gnea/grbl into this repo, and making the modifications once again
    [alarm_codes_en_US.csv, build_option_codes_en_US.csv, config.h, cpu_map.h, defaults.h, error_codes_en_US.csv, setting_codes_en_US.csv]
2021-09-10 Grbl directory is now included in this repo instead of beeing a submodule.
    [config.h, defaults.h]
2021-09-10 Limit switches work in progress.
2021-09-14 Limit switches and homing.
    [config.h, defaults.h]
2021-09-14 Directory name change : grbl2 -> gnea-grbl
    [alarm_codes_en_US.csv, build_option_codes_en_US.csv, config.h, cpu_map.h, defaults.h, error_codes_en_US.csv, setting_codes_en_US.csv]
2021-09-14 Work in progress on the NVS (in flash) aka eeprom implementation. Does not work yet.
    [main.c]
2021-09-16 Work started on the PCB.
    [motors.kicad_sch, plotter.kicad_pcb, plotter.kicad_sch]
2021-09-17 Moving to STM32F405 and the final pinout (as on the PCB in the future).
    [plotter.kicad_pcb, plotter.kicad_sch]
2021-09-17 Threads WIP
2021-09-20 PCB and 3d model. Still work in progress.
    [body3.3mf, body3.stl, carriage-bottom.3mf, carriage-bottom.stl, carriage-top-quarter.stl, carriage-top.3mf, carriage-top.stl, gt2.FCStd]
2021-09-21 Thread priorites.
    [motors.kicad_sch, plotter.kicad_pcb, plotter.kicad_sch]
2021-09-21 Max feed rate increased to 15000mm/min. But the scale of the distances traveled is wrong. Instead of 10cm it goes like 15-20.
    [defaults.h]
2021-09-23 Work on the SD cared impl.
    [defaults.h]
2021-09-23 SD card subsystem intercepts the GRBL comms nicely.
2021-09-24 Communication with the GRBL for SD card impl.
    [defaults.h, motors.kicad_sch, plotter.kicad_pcb, plotter.kicad_sch]
2021-09-25 Jojs -0.5mm when encoder pressed (encoder with a button).
2021-09-27 Working state, but a little bit unstable at a times.
    [sdCard.cc]
2021-09-27 Encoder, and jogging.
2021-09-27 Encoder and jogging.
2021-09-28 Encoder. Debuncing. Best so far, but not quite
2021-09-29 Encoder done better.
2021-09-29 Encoder OK.
2021-10-05 I finally got the SD card to work.
    [plotter.kicad_pcb, plotter.kicad_sch]
2021-10-17 Bringing up the first PCB
    [446.csv, 476.csv, motors.kicad_sch, plotter.kicad_sch, sd-card-comms.ods]
2021-10-20 Schematics minor changes
    [motors.kicad_sch, plotter.kicad_pcb, plotter.kicad_sch]
2021-10-26 FreeCad files mod
    [17HS4401.FCStd, gt2.FCStd, pen-holder-compact-ModelSliderA.stl, pen-holder-compact-ModelSouth attachment body.stl, pen-holder-compact.FCStd, structure.FCStd]
2021-10-27 3d model work
    [body3.3mf, body3.stl, carriage-bottom.3mf, carriage-bottom.stl, carriage-top-quarter.stl, carriage-top.3mf, carriage-top.stl, knob.stl]
2021-11-13 3d model changes mostly
    [17HS4401.FCStd, carrier.3mf, defaults.h, east-supports.3mf, gt2.FCStd, misc.FCStd, pcb.FCStd, pen-holder-compact.FCStd]
2023-06-25 Undefined initialization levels used problem resolved
    [hw_timer.h, hw_timer_stm32.c, zephyrGrblPeripherals.h]
2023-07-03 Steppers config upudated
    [motors.kicad_sch, plotter.kicad_pcb, plotter.kicad_sch]
2023-07-04 OLED screen initialization problem fixed
    [plotter.kicad_pcb]
