iwasz/zephyr-grbl/(notices)

Notices in the files:
deps/gnea-grbl/grbl/defaults.h:
Copyright (c) 2012-2016 Sungeun K. Jeon for Gnea Research LLC
Grbl is free software: you can redistribute it and/or modify
it under the terms of the GNU General Public License as published by
the Free Software Foundation, either version 3 of the License, or
(at your option) any later version.
deps/gnea-grbl/grbl/config.h:
Copyright (c) 2009-2011 Simen Svale Skogsrud
